betocool-prog/Arduino_codec/Arduino_codec.kicad_pcb

## KiCad design Arduino_codec.kicad_pcb (2022-01-30)

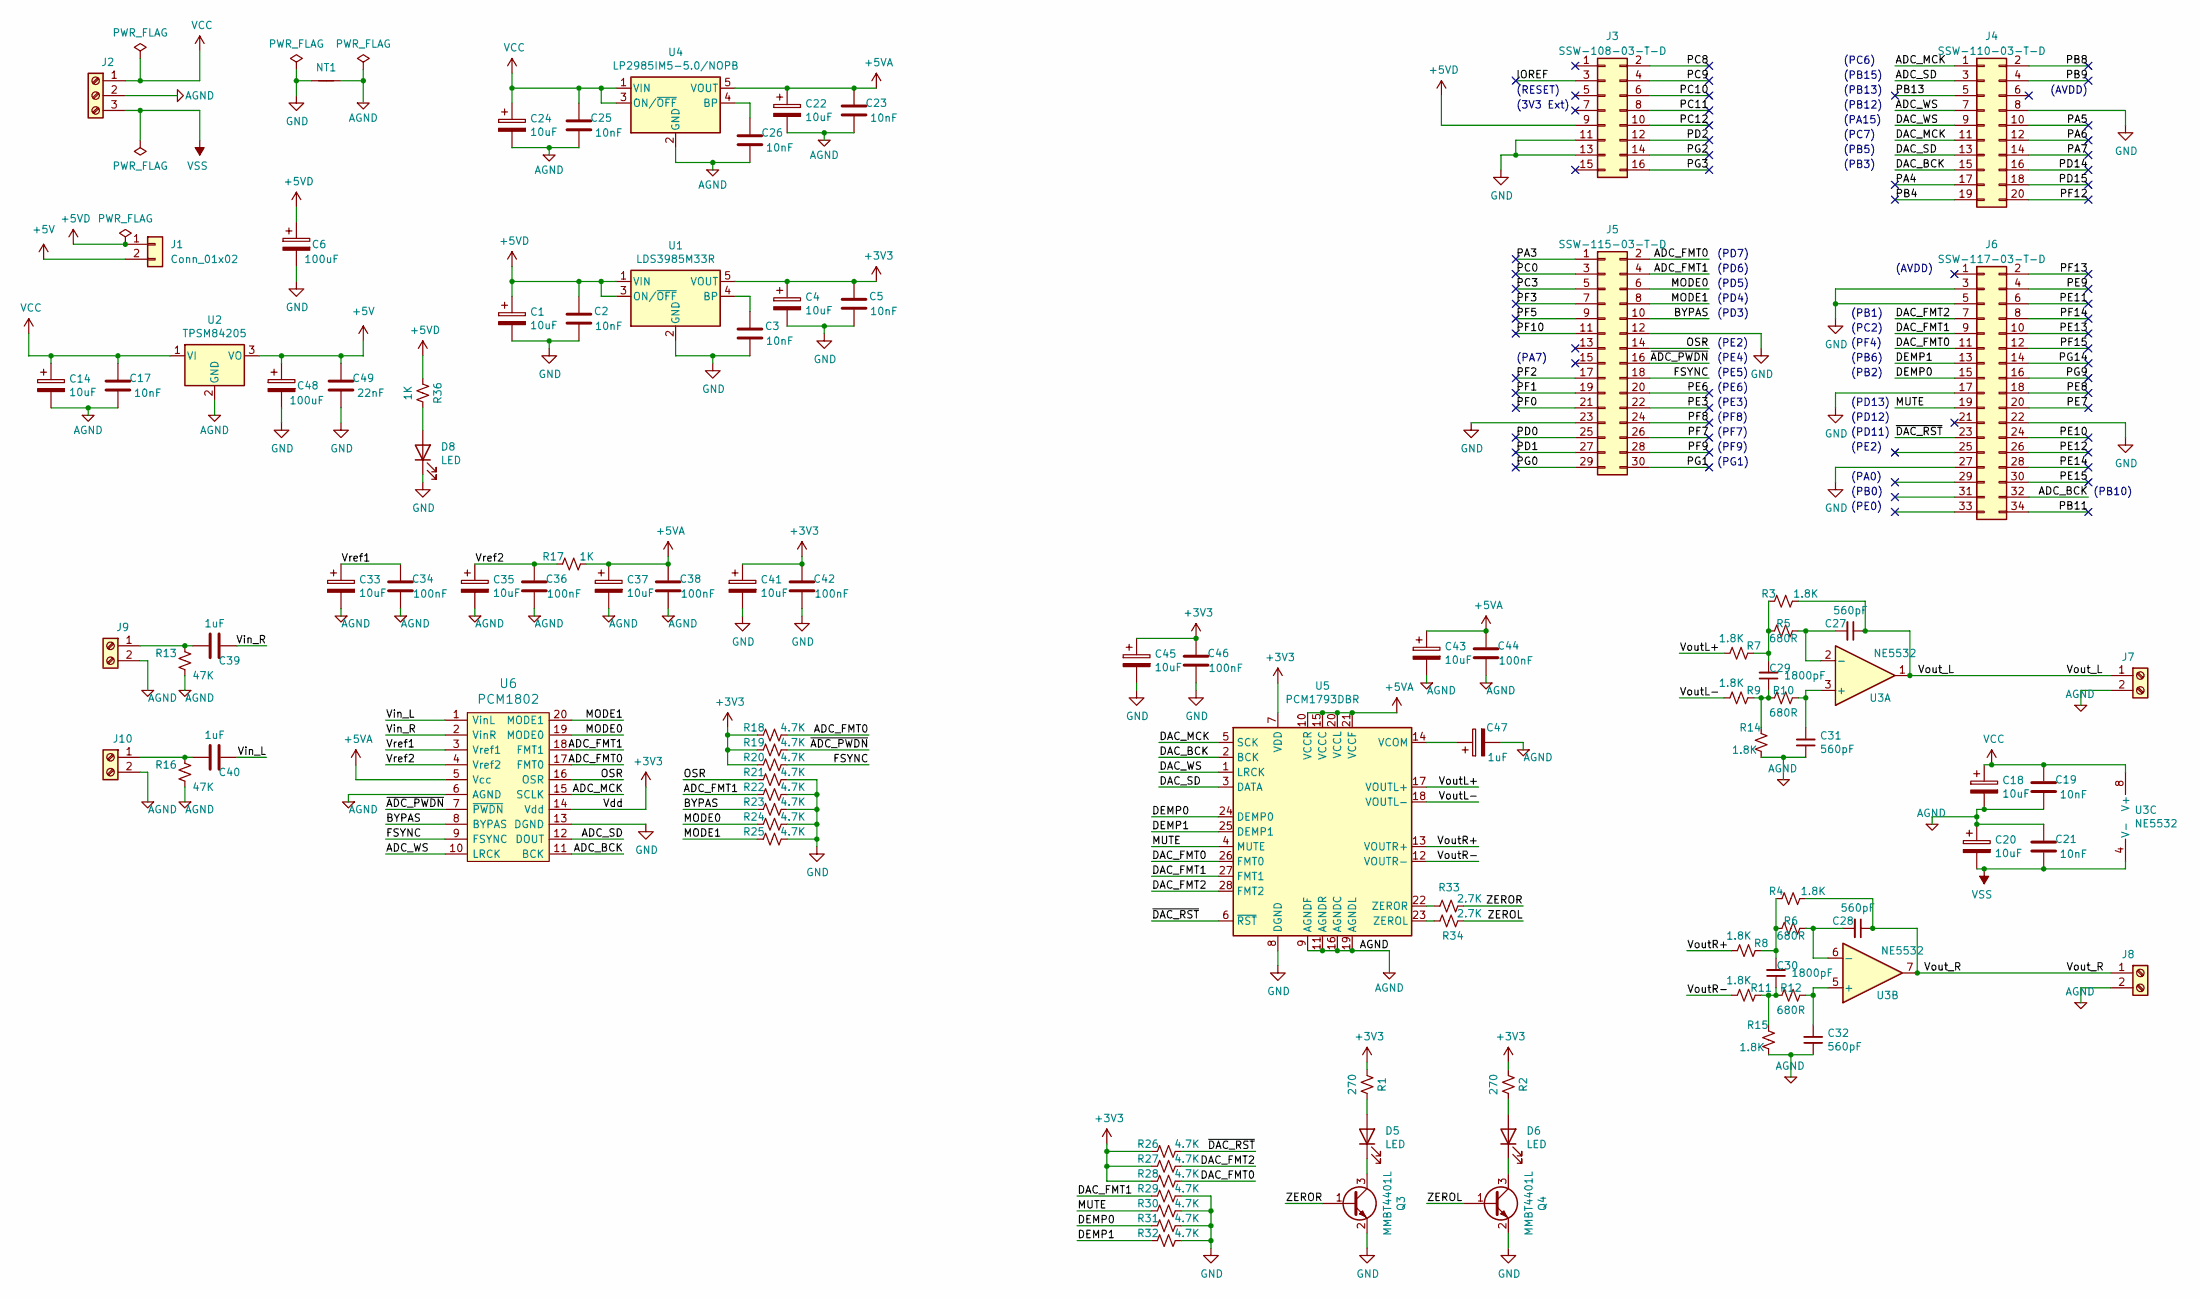
[picture p1: schematic Arduino_codec.kicad_sch]

Parts:
C1, C4, C14, C18, C20, C22, C24: 10uF; CP_EIA-6032-20_AVX-F_Pad2.25x2.35mm_HandSolder; Part # TRJC106K035R0600
C2, C3, C5: 10nF; C_0603_1608Metric_Pad1.08x0.95mm_HandSolder; Part # C0603C103M5RACTU
C6, C48: 100uF; CP_EIA-7343-30_AVX-N_Pad2.25x2.55mm_HandSolder; Part # TPSD107M010R0050
C17, C19, C21, C23, C25, C26: 10nF; C_0603_1608Metric_Pad1.05x0.95mm_HandSolder; Part # C0603C103M5RACTU
C27, C28, C31, C32: 560pF; C_0603_1608Metric_Pad1.05x0.95mm_HandSolder
C29, C30: 1800pF; C_0603_1608Metric_Pad1.05x0.95mm_HandSolder
C33, C35, C37, C41, C43, C45: 10uF; CP_EIA-2012-15_AVX-P_Pad1.30x1.05mm_HandSolder; Part # TLJR106M010R2000
C34, C36, C38, C42, C44, C46: 100nF; C_0603_1608Metric_Pad1.05x0.95mm_HandSolder; Part # C0603C103M5RACTU
C39, C40: 1uF; C_1210_3225Metric_Pad1.42x2.65mm_HandSolder; Part # ECP-U1C105MA5
C47: 1uF; CP_EIA-2012-15_AVX-P_Pad1.30x1.05mm_HandSolder; Part # TPSR105K010R9000
C49: 22nF; C_0603_1608Metric_Pad1.05x0.95mm_HandSolder; Part # C0603C223M5RAC7867
D5, D6, D8: LED; LED_0603_1608Metric_Pad1.05x0.95mm_HandSolder; Part # LT Q39G-Q1OO-25-1
J1: Conn_01x02; PinHeader_1x02_P2.54mm_Vertical
J2: Screw_Terminal_01x03; TerminalBlock_Phoenix_MPT-0,5-3-2.54_1x03_P2.54mm_Horizontal; Part # 1725669
J3: Conn_02x08_Odd_Even; PinHeader_2x08_P2.54mm_Vertical; Part # SSW-108-03-T-D
J4: Conn_02x10_Odd_Even; PinHeader_2x10_P2.54mm_Vertical; Part # SSW-110-03-T-D
J5: Conn_02x15_Odd_Even; PinHeader_2x15_P2.54mm_Vertical; Part # SSW-115-03-T-D
J6: Conn_02x17_Odd_Even; PinHeader_2x17_P2.54mm_Vertical; Part # SSW-117-03-T-D
J7, J8, J9, J10: Screw_Terminal_01x02; TerminalBlock_Phoenix_MPT-0,5-2-2.54_1x02_P2.54mm_Horizontal; Part # 1725656
NT1: Net-Tie_2; NetTie-2_SMD_Pad2.0mm
Q3, Q4: MMBT4401L; SOT-23; Part # MMBT4401L
R1, R2: 270; R_0603_1608Metric_Pad0.98x0.95mm_HandSolder
R3, R4, R7, R8, R9, R11, R14, R15: 1.8K; R_0603_1608Metric_Pad1.05x0.95mm_HandSolder
R5, R6, R10, R12: 680R; R_0603_1608Metric_Pad1.05x0.95mm_HandSolder
R13, R16: 47K; R_0603_1608Metric_Pad1.05x0.95mm_HandSolder
R17, R36: 1K; R_0603_1608Metric_Pad1.05x0.95mm_HandSolder
R18, R19, R20, R21, R22, R23, R24, R25, R26, R27, R28, R29, R30, R31, R32: 4.7K; R_0603_1608Metric_Pad1.05x0.95mm_HandSolder
R33, R34: 2.7K; R_0603_1608Metric_Pad1.05x0.95mm_HandSolder
U1: LDS3985M33R; SOT-23-5_HandSoldering; Part # LDS3985M33R
U2: TPSM84205; TO-220-3_Vertical
U3: NE5532; SOIC-8_3.9x4.9mm_P1.27mm; Part # NE5532DR
U4: LP2985IM5-5.0/NOPB; SOT-23-5_HandSoldering; Part # LP2985IM5-5.0/NOPB
U5: PCM1793DBR; SSOP-28_5.3x10.2mm_P0.65mm; Part # PCM1793DBR
U6: PCM1802; SSOP-20_5.3x7.2mm_P0.65mm; Part # PCM1802DBR

Connections:
+3V3: C4.1, C5.1, C41.1, C42.1, C45.1, C46.1, R1.2, R2.2, R18.1, R19.1, R20.1, R26.1, R27.1, R28.1, U1.5 (VOUT), U5.7 (VDD), U6.14 (Vdd)
+5V: C48.1, C49.1, J1.2, U2.3 (VO)
+5VA: C22.1, C23.1, C37.1, C38.1, C43.1, C44.1, R17.2, U4.5 (VOUT), U5.10 (VCCR), U5.15 (VCCC), U5.20 (VCCL), U5.21 (VCCF), U6.5 (Vcc)
+5VD: C1.1, C2.1, C6.1, J1.1, J3.9, R36.2, U1.1 (VIN), U1.3 (ON/~OFF)
/ADC_BCK: J6.32, U6.11 (BCK)
/ADC_FMT0: J5.2, R18.2, U6.17 (FMT0)
/ADC_FMT1: J5.4, R22.1, U6.18 (FMT1)
/ADC_MCK: J4.1, U6.15 (SCLK)
/ADC_SD: J4.3, U6.12 (DOUT)
/ADC_WS: J4.7, U6.10 (LRCK)
/BYPAS: J5.10, R23.1, U6.8 (BYPAS)
/DAC_BCK: J4.15, U5.2 (BCK)
/DAC_FMT0: J6.11, R28.2, U5.26 (FMT0)
/DAC_FMT1: J6.9, R29.1, U5.27 (FMT1)
/DAC_FMT2: J6.7, R27.2, U5.28 (FMT2)
/DAC_MCK: J4.11, U5.5 (SCK)
/DAC_SD: J4.13, U5.3 (DATA)
/DAC_WS: J4.9, U5.1 (LRCK)
/DEMP0: J6.15, R31.1, U5.24 (DEMP0)
/DEMP1: J6.13, R32.1, U5.25 (DEMP1)
/FSYNC: J5.18, R20.2, U6.9 (FSYNC)
/IOREF: J3.3
/MODE0: J5.6, R24.1, U6.19 (MODE0)
/MODE1: J5.8, R25.1, U6.20 (MODE1)
/MUTE: J6.19, R30.1, U5.4 (MUTE)
/OSR: J5.14, R21.1, U6.16 (OSR)
/PA3: J5.1
/PA4: J4.17
/PA5: J4.10
/PA6: J4.12
/PA7: J4.14
/PB4: J4.19
/PB8: J4.2
/PB9: J4.4
/PB11: J6.34
/PB13: J4.5
/PC0: J5.3
/PC3: J5.5
/PC8: J3.2
/PC9: J3.4
/PC10: J3.6
/PC11: J3.8
/PC12: J3.10
/PD0: J5.25
/PD1: J5.27
/PD2: J3.12
/PD14: J4.16
/PD15: J4.18
/PE3: J5.22
/PE6: J5.20
/PE7: J6.20
/PE8: J6.18
/PE9: J6.4
/PE10: J6.24
/PE11: J6.6
/PE12: J6.26
/PE13: J6.10
/PE14: J6.28
/PE15: J6.30
/PF0: J5.21
/PF1: J5.19
/PF2: J5.17
/PF3: J5.7
/PF5: J5.9
/PF7: J5.26
/PF8: J5.24
/PF9: J5.28
/PF10: J5.11
/PF12: J4.20
/PF13: J6.2
/PF14: J6.8
/PF15: J6.12
/PG0: J5.29
/PG1: J5.30
/PG2: J3.14
/PG3: J3.16
/PG9: J6.16
/PG14: J6.14
/Vin_L: C40.1, U6.1 (VinL)
/Vin_R: C39.1, U6.2 (VinR)
/VoutL+: R7.2, U5.17 (VOUTL+)
/VoutL-: R9.2, U5.18 (VOUTL-)
/VoutR+: R8.2, U5.13 (VOUTR+)
/VoutR-: R11.2, U5.12 (VOUTR-)
/Vout_L: C27.1, J7.1, R3.1, U3.1
/Vout_R: C28.1, J8.1, R4.1, U3.7
/Vref1: C33.1, C34.1, U6.3 (Vref1)
/Vref2: C35.1, C36.1, R17.1, U6.4 (Vref2)
/ZEROL: Q4.1 (B), R34.2
/ZEROR: Q3.1 (B), R33.2
/~ADC_PWDN: J5.16, R19.2, U6.7 (~PWDN)
/~DAC_RST: J6.23, R26.2, U5.6 (~RST)
AGND: C14.2, C17.2, C18.2, C19.2, C20.1, C21.1, C22.2, C23.2, C24.2, C25.2, C26.2, C31.1, C32.1, C33.2, C34.2, C35.2, C36.2, C37.2, C38.2, C43.2, C44.2, C47.2, J2.2, J7.2, J8.2, J9.2, J10.2, NT1.2, R13.2, R14.1, R15.1, R16.2, U2.2 (GND), U4.2 (GND), U5.9 (AGNDF), U5.11 (AGNDR), U5.16 (AGNDC), U5.19 (AGNDL), U6.6 (AGND)
GND: C1.2, C2.2, C3.2, C4.2, C5.2, C6.2, C41.2, C42.2, C45.2, C46.2, C48.2, C49.2, D8.1 (K), J3.11, J3.13, J4.8, J5.12, J5.23, J6.3, J6.5, J6.17, J6.22, J6.27, NT1.1, Q3.2 (E), Q4.2 (E), R21.2, R22.2, R23.2, R24.2, R25.2, R29.2, R30.2, R31.2, R32.2, U1.2 (GND), U5.8 (DGND), U6.13 (DGND)
unnamed: C3.1, U1.4 (BP)
unnamed: C26.1, U4.4 (BP)
unnamed: C27.2, R5.1, U3.2 (-)
unnamed: C28.2, R6.1, U3.6 (-)
unnamed: C29.1, R9.1, R10.2, R14.2
unnamed: C29.2, R3.2, R5.2, R7.1
unnamed: C30.1, R11.1, R12.2, R15.2
unnamed: C30.2, R4.2, R6.2, R8.1
unnamed: C31.2, R10.1, U3.3 (+)
unnamed: C32.2, R12.1, U3.5 (+)
unnamed: C39.2, J9.1, R13.1
unnamed: C40.2, J10.1, R16.1
unnamed: C47.1, U5.14 (VCOM)
unnamed: D5.1 (K), Q3.3 (C)
unnamed: D5.2 (A), R1.1
unnamed: D6.1 (K), Q4.3 (C)
unnamed: D6.2 (A), R2.1
unnamed: D8.2 (A), R36.1
unnamed: R33.1, U5.22 (ZEROR)
unnamed: R34.1, U5.23 (ZEROL)
VCC: C14.1, C17.1, C18.1, C19.1, C24.1, C25.1, J2.1, U2.1 (VI), U3.8 (V+), U4.1 (VIN), U4.3 (ON/~OFF)
VSS: C20.2, C21.2, J2.3, U3.4 (V-)

Notes on the sheet:
(PD11)
(PA7)
(PE5)
(PD13)
(RESET)
(PF9)
(PE0)
(AVDD)
(PE6)
(PD12)
(PE3)
(PB3)
(PD6)
(PE2)
(PB13)
(PE4)
(PF7)
(PB2)
(PB6)
(PB15)
(PC6)
(PG1)
(PD4)
(PB0)
(PD3)
(PA0)
(PF4)
(PA15)
(PD5)
(PF8)
(PB10)
(PB1)
(PC7)
(PC2)
(3V3 Ext)
(PB5)
(PD7)
(PB12)

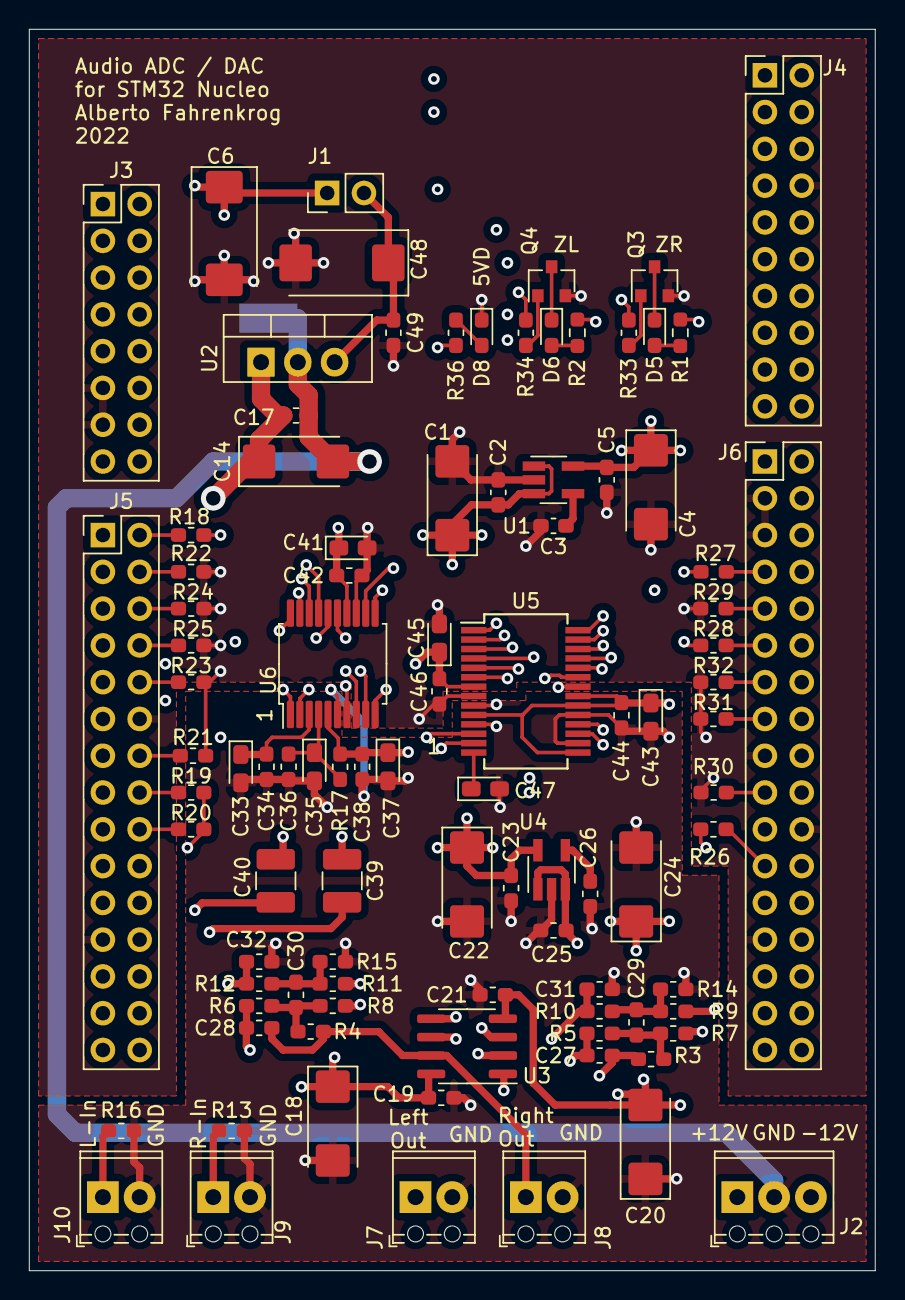
[picture p2: board Arduino_codec.kicad_pcb from above]

Board: 4 copper layers, 58.4 x 85.7 mm, 97 parts (1 on the bottom side), 63 nets.
